neloe/stella-1.2-pcbs/stella-1.2-rs/stella-1.2-rs-permaproto-replacement.kicad_pcb

## KiCad design stella-1.2-rs/stella-1.2-rs-permaproto-replacement.kicad_pcb (2026-10-09)

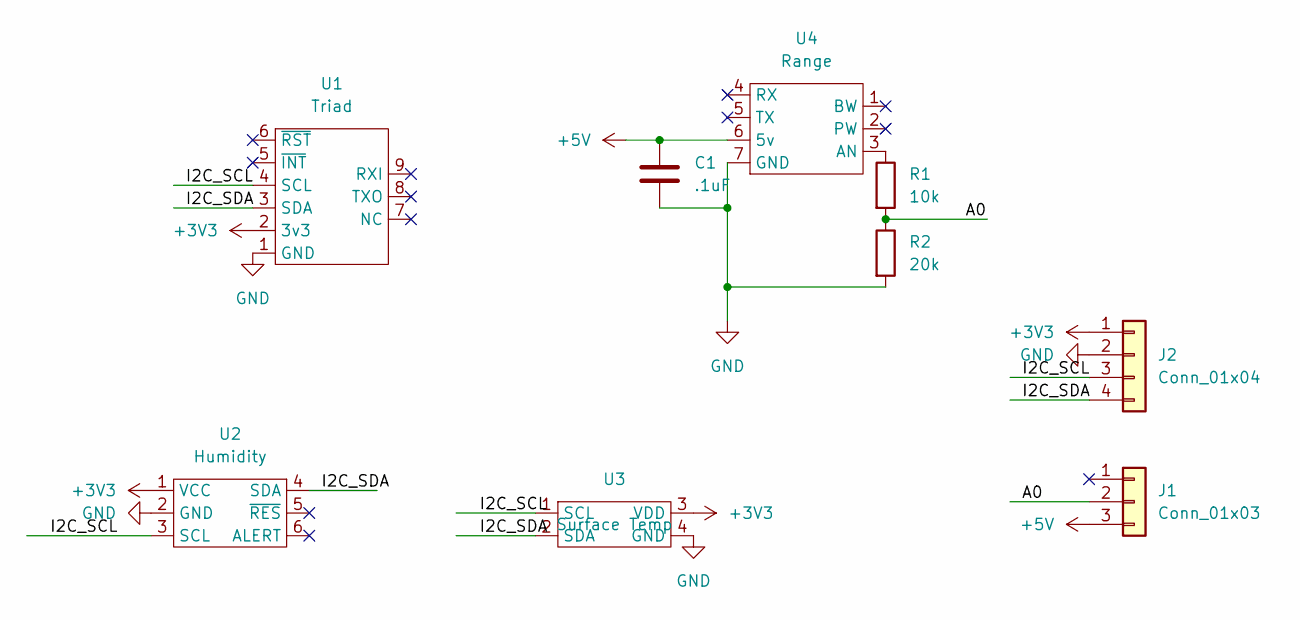
[picture p4: schematic stella-1.2-rs-permaproto-replacement.kicad_sch]

Parts:
C1: .1uF; C_Radial_D6.3mm_H5.0mm_P2.50mm
J1: Conn_01x03; MagConn-3P-M_5360
J2: Conn_01x04; MagConn-4P-M_5358
R1: 10k; R_Axial_DIN0204_L3.6mm_D1.6mm_P7.62mm_Horizontal
R2: 20k; R_Axial_DIN0204_L3.6mm_D1.6mm_P7.62mm_Horizontal
U1: Triad; Triad_sen15050
U2: Humidity; Humidity_5989
U3: Surface Temp; TO-39-4
U4: Range; Rangefinder_LV-EZ1

Connections:
+3V3: J2.1, U1.2 (3v3), U2.1 (VCC), U3.3 (VDD)
+5V: C1.1, J1.3, U4.6 (5v)
/A0: J1.2, R1.2, R2.1
/I2C_SCL: J2.3, U1.4 (SCL), U2.3 (SCL), U3.1 (SCL)
/I2C_SDA: J2.4, U1.3 (SDA), U2.4 (SDA), U3.2 (SDA)
GND: C1.2, J2.2, R2.2, U1.1 (GND), U2.2 (GND), U3.4 (GND), U4.7 (GND)
unnamed: R1.1, U4.3 (AN)

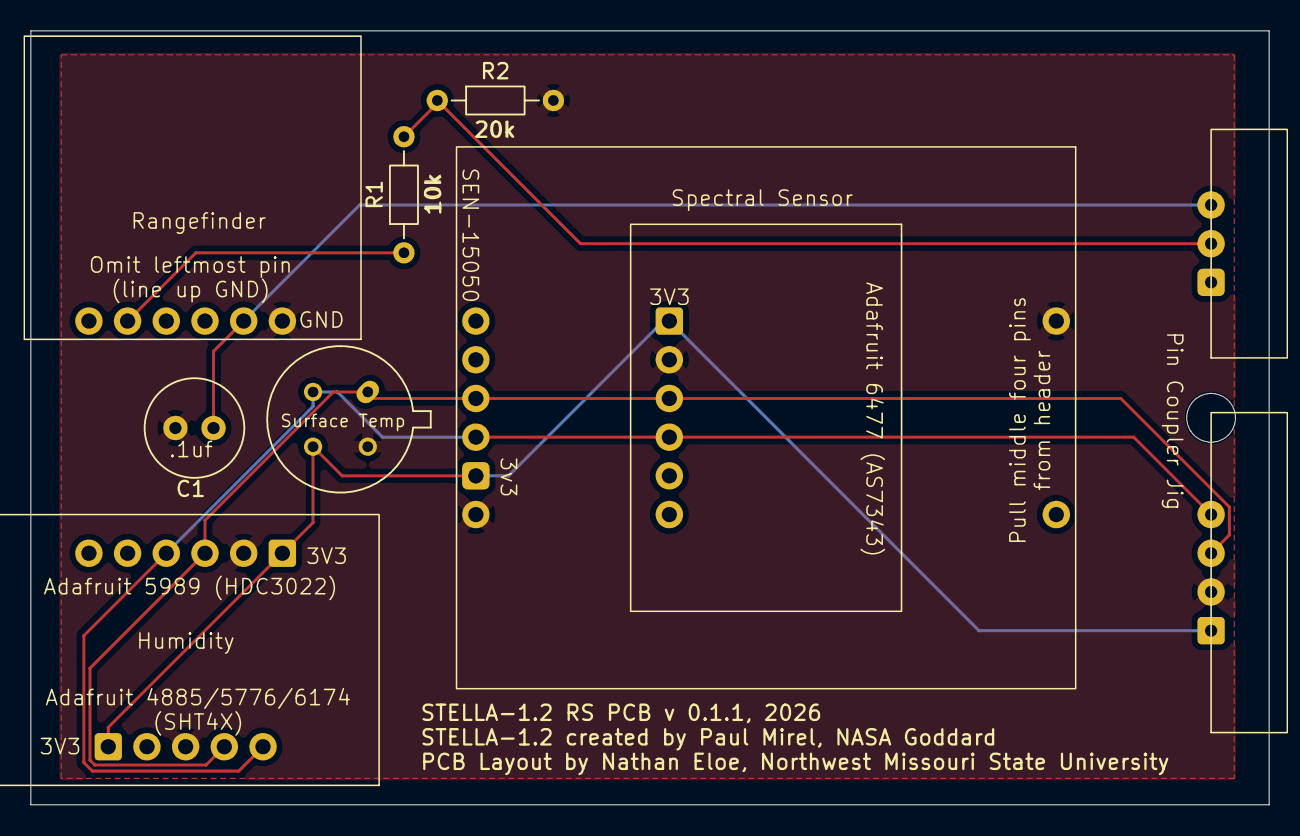
[picture p5: board stella-1.2-rs-permaproto-replacement.kicad_pcb from above]

Board: 2 copper layers, 81.3 x 50.8 mm, 10 parts (0 on the bottom side), 7 nets.

Other parts of the board:
PinCouplerJig: MountingHole_3.2mm_M3
