neloe/stella-1.2-pcbs/stella-1.2-base/stella-1.2-permaproto-replacement.kicad_pcb

## KiCad design stella-1.2-base/stella-1.2-permaproto-replacement.kicad_pcb (2026-10-09)

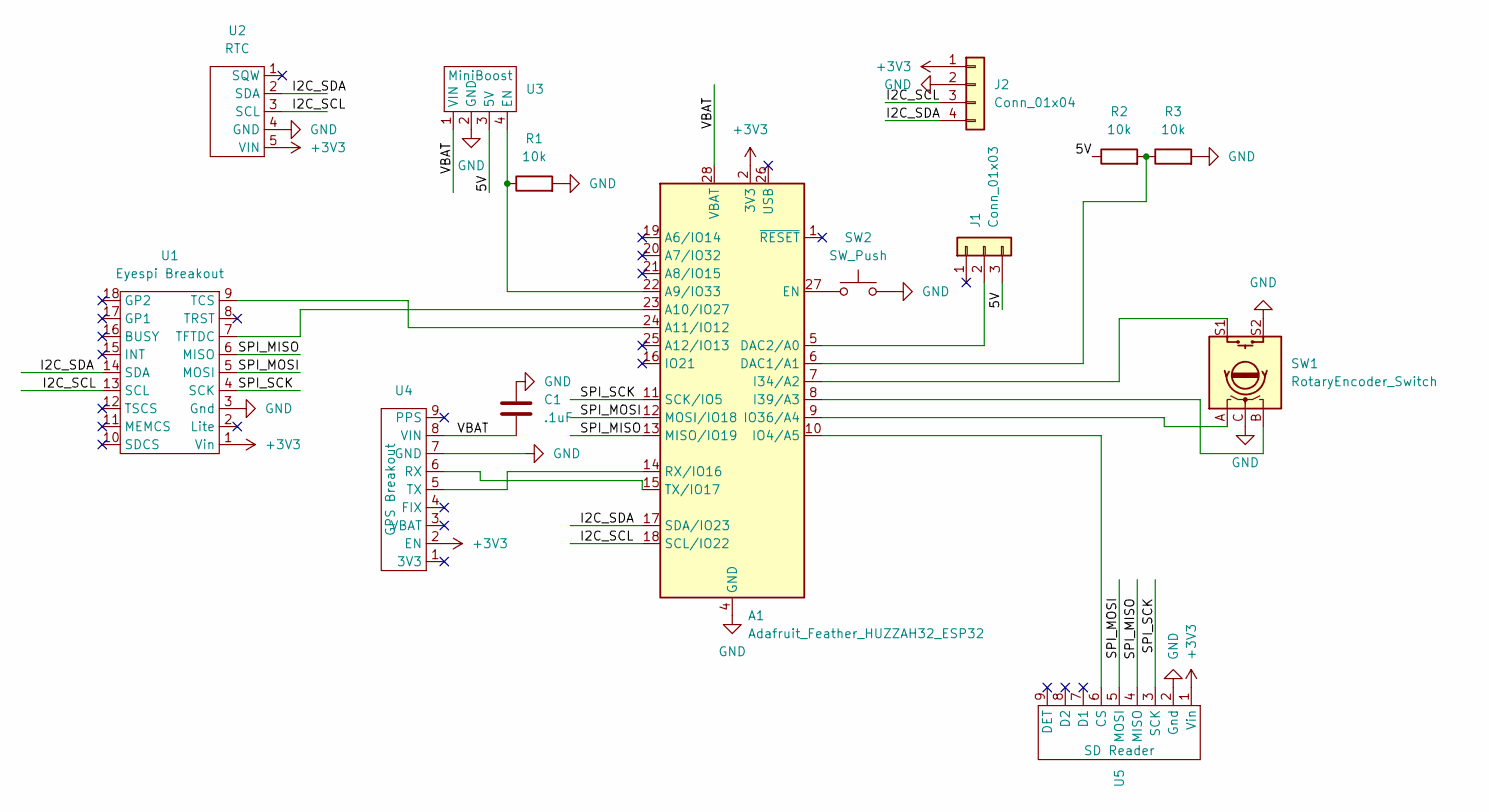
[picture p6: schematic stella-1.2-permaproto-replacement.kicad_sch]

Parts:
A1: Adafruit_Feather_HUZZAH32_ESP32; Adafruit_Feather
C1: .1uF; C_Radial_D6.3mm_H7.0mm_P2.50mm
J1: Conn_01x03; MagConn-3P-F_5360
J2: Conn_01x04; MagConn-4P-F_5358
R1, R2, R3: 10k; R_Axial_DIN0204_L3.6mm_D1.6mm_P7.62mm_Horizontal
SW1: RotaryEncoder_Switch; RotaryEncoder_Bourns_Vertical_PEC12R-3x17F-Sxxxx
SW2: SW_Push; SWITCH_03211B
U1: Eyespi Breakout; Eyespi_5613
U2: RTC; RTC_5198_3295
U3: MiniBoost; MiniBoost_4654
U4: GPS Breakout; GPS_5440
U5: SD Reader; SDCard_4682

Connections:
+3V3: A1.2 (3V3), J2.1, U1.1 (Vin), U2.5 (VIN), U4.2 (EN), U5.1 (Vin)
/5V: J1.3, R2.1, U3.3 (5V)
/I2C_SCL: A1.18 (SCL/IO22), J2.3, U1.13 (SCL), U2.3 (SCL)
/I2C_SDA: A1.17 (SDA/IO23), J2.4, U1.14 (SDA), U2.2 (SDA)
/SPI_MISO: A1.13 (MISO/IO19), U1.6 (MISO), U5.4 (MISO)
/SPI_MOSI: A1.12 (MOSI/IO18), U1.5 (MOSI), U5.5 (MOSI)
/SPI_SCK: A1.11 (SCK/IO5), U1.4 (SCK), U5.3 (SCK)
/VBAT: A1.28 (VBAT), C1.2, U3.1 (VIN), U4.8 (VIN)
GND: A1.4 (GND), C1.1, J2.2, R1.2, R3.2, SW1.C, SW1.S2, SW2.2, U1.3 (Gnd), U2.4 (GND), U3.2 (GND), U4.7 (GND), U5.2 (Gnd)
unnamed: A1.22 (A9/IO33), R1.1, U3.4 (EN)
unnamed: A1.23 (A10/IO27), U1.7 (TFTDC)
unnamed: A1.24 (A11/IO12), U1.9 (TCS)
unnamed: A1.6 (DAC1/A1), R2.2, R3.1
unnamed: A1.5 (DAC2/A0), J1.2
unnamed: A1.27 (EN), SW2.1
unnamed: A1.7 (I34/A2), SW1.S1
unnamed: A1.8 (I39/A3), SW1.B
unnamed: A1.10 (IO4/A5), U5.6 (CS)
unnamed: A1.9 (IO36/A4), SW1.A
unnamed: A1.14 (RX/IO16), U4.5 (TX)
unnamed: A1.15 (TX/IO17), U4.6 (RX)

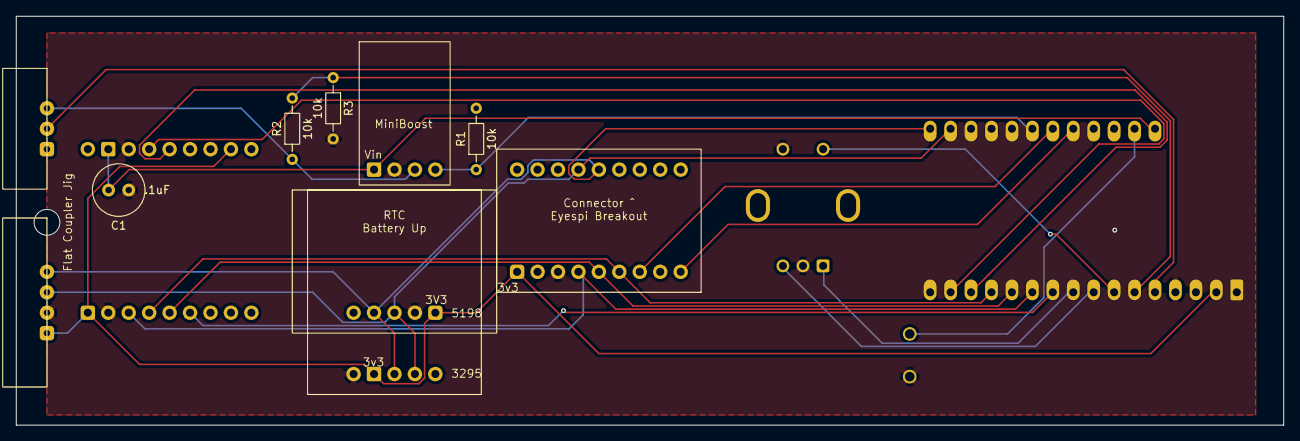
[picture p7: board stella-1.2-permaproto-replacement.kicad_pcb from above]

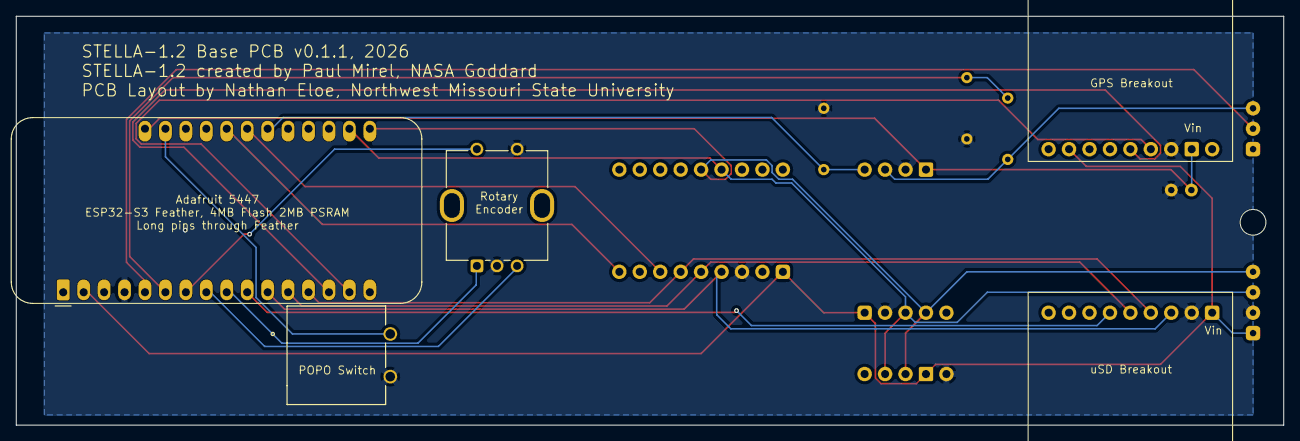
[picture p8: board stella-1.2-permaproto-replacement.kicad_pcb from below]

Board: 2 copper layers, 157.5 x 50.8 mm, 15 parts (5 on the bottom side), 21 nets.

Other parts of the board:
FlatCouplerJig: MountingHole_3.2mm_M3
