neloe/stella-1.2-pcbs/(commit log)

2026-07-16 Draft first attempt at permaproto replacement
    [stella-1.2-permaproto-replacement-B_Cu.gbr, stella-1.2-permaproto-replacement-B_Mask.gbr, stella-1.2-permaproto-replacement-B_Paste.gbr, stella-1.2-permaproto-replacement-B_Silkscreen.gbr, stella-1.2-permaproto-replacement-Edge_Cuts.gbr, stella-1.2-permaproto-replacement-F_Cu.gbr, stella-1.2-permaproto-replacement-F_Mask.gbr, stella-1.2-permaproto-replacement-F_Paste.gbr]
2026-07-17 Finalize v0.1.0 of base pcb
    [stella-1.2-permaproto-replacement-B_Cu.gbr, stella-1.2-permaproto-replacement-B_Mask.gbr, stella-1.2-permaproto-replacement-B_Paste.gbr, stella-1.2-permaproto-replacement-B_Silkscreen.gbr, stella-1.2-permaproto-replacement-Edge_Cuts.gbr, stella-1.2-permaproto-replacement-F_Cu.gbr, stella-1.2-permaproto-replacement-F_Mask.gbr, stella-1.2-permaproto-replacement-F_Paste.gbr]
2026-07-18 Create v0.1.0 of Remote Sensing expansion board
    [stella-1.2-permaproto-replacement.kicad_pcb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]
2026-08-12 Incorporate build fixes in base (size, pins, gnd plane thermal)
    [stella-1.2-permaproto-replacement-B_Cu.gbr, stella-1.2-permaproto-replacement-B_Mask.gbr, stella-1.2-permaproto-replacement-B_Paste.gbr, stella-1.2-permaproto-replacement-B_Silkscreen.gbr, stella-1.2-permaproto-replacement-Edge_Cuts.gbr, stella-1.2-permaproto-replacement-F_Cu.gbr, stella-1.2-permaproto-replacement-F_Mask.gbr, stella-1.2-permaproto-replacement-F_Paste.gbr]
2026-08-12 Add RS build fixes (size, pins)
    [stella-1.2-rs-permaproto-replacement.kicad_pcb]
2026-08-12 Add Adafruit AS7343 footprint to rs board
    [stella-1.2-rs-permaproto-replacement-B_Cu.gbr, stella-1.2-rs-permaproto-replacement-B_Mask.gbr, stella-1.2-rs-permaproto-replacement-B_Paste.gbr, stella-1.2-rs-permaproto-replacement-B_Silkscreen.gbr, stella-1.2-rs-permaproto-replacement-Edge_Cuts.gbr, stella-1.2-rs-permaproto-replacement-F_Cu.gbr, stella-1.2-rs-permaproto-replacement-F_Mask.gbr, stella-1.2-rs-permaproto-replacement-F_Paste.gbr]
2026-08-12 Save changes for rs kicad project
    [stella-1.2-rs-permaproto-replacement.kicad_pcb]
2026-08-12 Update gerbers with silkscreen info
    [stella-1.2-permaproto-replacement-B_Cu.gbr, stella-1.2-permaproto-replacement-B_Mask.gbr, stella-1.2-permaproto-replacement-B_Paste.gbr, stella-1.2-permaproto-replacement-B_Silkscreen.gbr, stella-1.2-permaproto-replacement-Edge_Cuts.gbr, stella-1.2-permaproto-replacement-F_Cu.gbr, stella-1.2-permaproto-replacement-F_Mask.gbr, stella-1.2-permaproto-replacement-F_Paste.gbr]
2026-09-15 Add Paul M attribution for NASA Stella
    [stella-1.2-permaproto-replacement-B_Cu.gbr, stella-1.2-permaproto-replacement-B_Mask.gbr, stella-1.2-permaproto-replacement-B_Paste.gbr, stella-1.2-permaproto-replacement-B_Silkscreen.gbr, stella-1.2-permaproto-replacement-Edge_Cuts.gbr, stella-1.2-permaproto-replacement-F_Cu.gbr, stella-1.2-permaproto-replacement-F_Mask.gbr, stella-1.2-permaproto-replacement-F_Paste.gbr]
2026-10-09 Cleanup gitignore files from base pcb
    [stella-1.2-permaproto-replacement-B_Cu.gbr, stella-1.2-permaproto-replacement-B_Mask.gbr, stella-1.2-permaproto-replacement-B_Paste.gbr, stella-1.2-permaproto-replacement-B_Silkscreen.gbr, stella-1.2-permaproto-replacement-Edge_Cuts.gbr, stella-1.2-permaproto-replacement-F_Cu.gbr, stella-1.2-permaproto-replacement-F_Mask.gbr, stella-1.2-permaproto-replacement-F_Paste.gbr]
2026-10-09 Rename base kicad folder for clarity
    [stella-1.2-permaproto-replacement.kicad_pcb, stella-1.2-permaproto-replacement.kicad_sch]
2026-10-09 Clean up silkscreens on base pcb
    [stella-1.2-permaproto-replacement.kicad_pcb]
2026-10-09 Rename RS kicad folder for clarity
    [stella-1.2-rs-permaproto-replacement-B_Cu.gbr, stella-1.2-rs-permaproto-replacement-B_Mask.gbr, stella-1.2-rs-permaproto-replacement-B_Paste.gbr, stella-1.2-rs-permaproto-replacement-B_Silkscreen.gbr, stella-1.2-rs-permaproto-replacement-Edge_Cuts.gbr, stella-1.2-rs-permaproto-replacement-F_Cu.gbr, stella-1.2-rs-permaproto-replacement-F_Mask.gbr, stella-1.2-rs-permaproto-replacement-F_Paste.gbr]
2026-10-09 Remove ignored files from RS project
    [stella-1.2-rs-permaproto-replacement-B_Cu.gbr, stella-1.2-rs-permaproto-replacement-B_Mask.gbr, stella-1.2-rs-permaproto-replacement-B_Paste.gbr, stella-1.2-rs-permaproto-replacement-B_Silkscreen.gbr, stella-1.2-rs-permaproto-replacement-Edge_Cuts.gbr, stella-1.2-rs-permaproto-replacement-F_Cu.gbr, stella-1.2-rs-permaproto-replacement-F_Mask.gbr, stella-1.2-rs-permaproto-replacement-F_Paste.gbr]
2026-10-09 Clean up silkscreen for RS PCB
    [stella-1.2-rs-permaproto-replacement.kicad_pcb]
2026-10-09 Tighten attribution to 3 lines
    [stella-1.2-permaproto-replacement.kicad_pcb, stella-1.2-rs-permaproto-replacement.kicad_pcb]
2026-10-09 Remove unneeded schematic refs from silkscreen
    [stella-1.2-permaproto-replacement.kicad_pcb]
2026-10-09 Add rendered PCB images for base and RS
2026-10-09 Add pins for SHT4x to RS
    [stella-1.2-rs-permaproto-replacement.kicad_pcb]
2026-10-12 Create readme with brief assembly instructions
